SreeniEadara/ElectriPi/(commit log)

2022-04-28 more file repair
    [PiPowerHAT.kicad_pcb, PiPowerHAT.kicad_sch]
2022-04-30 Updating to add freewheeling diodes, power LEDs, etc.
    [PiPowerHAT.kicad_sch]
2022-05-01 adding footprints assignment to sch
    [PiPowerHAT.kicad_sch]
2022-05-01 currently under development. Layout in progress
    [PiPowerHAT.kicad_pcb, PiPowerHAT.kicad_sch]
2022-05-02 changed out fuseholder, mounting holes, headers, removed i2c, etc
    [PiPowerHAT.kicad_pcb, PiPowerHAT.kicad_sch]
2022-05-02 cleanup and added proper JLC number for fuseholder
    [PiPowerHAT.kicad_sch]
2022-05-03 Layout V1 complete
    [PiPowerHAT.kicad_pcb, PiPowerHAT.kicad_sch]
2022-05-04 Adding panelization between breakouts. Updated layout and component position.
    [PiPowerHAT.kicad_pcb, PiPowerHAT.kicad_sch, breakout.kicad_sch]
2022-05-05 remove breakout board and add +5V out
    [PiPowerHAT.kicad_pcb, PiPowerHAT.kicad_sch, breakout.kicad_sch]
2022-05-06 Cleanup and miscellaneous changes. Changed fuseholder and FET
    [PiPowerHAT.kicad_pcb, PiPowerHAT.kicad_sch]
2022-05-06 Minor Updates and Cleaning
    Changed JLC field to LCSC
    Changed Aux power output to JST XH
    Small changes to silkscreen labels to hide below components once fitted
    Added connector name labels to Frontsilk
    [PiPowerHAT.kicad_pcb, PiPowerHAT.kicad_sch]
2022-05-06 added additional silkscreen
    [PiPowerHAT.kicad_pcb]
2022-05-06 BOM Updates
    Mounting holes and other items not sent to automated manufacture excluded from BOM
    [PiPowerHAT.kicad_pcb, PiPowerHAT.kicad_sch]
2022-05-06 BOM and Gerber Generated
    BOM and Gerber Generated. Files sent for manufacture V0.1
    [PiPowerHAT-B_Cu.gbr, PiPowerHAT-B_Paste.gbr, PiPowerHAT-B_Silkscreen.gbr, PiPowerHAT-Edge_Cuts.gbr, PiPowerHAT-F_Cu.gbr, PiPowerHAT-F_Mask.gbr, PiPowerHAT-F_Paste.gbr, PiPowerHAT-F_Silkscreen.gbr]
2022-05-11 PCBway export and minor changes
    V0.1.1 files generated for PCBway with B.Mask included.
    Dot added to Pin 1 on F.silk
    Added Metadata to work with PCBway BOM
    [PiPowerHAT-B_Cu.gbr, PiPowerHAT-B_Mask.gbr, PiPowerHAT-B_Paste.gbr, PiPowerHAT-B_Silkscreen.gbr, PiPowerHAT-Edge_Cuts.gbr, PiPowerHAT-F_Cu.gbr, PiPowerHAT-F_Mask.gbr, PiPowerHAT-F_Paste.gbr]
2022-05-12 Part Numbers for Littelfuse removed.
    [PiPowerHAT.kicad_sch]
2022-05-18 bug fixes
    [PiPowerHAT.kicad_pcb, PiPowerHAT.kicad_sch]
2022-05-22 changing project name to remove 'HAT' designation
    [PowerPi-JLC.csv, PowerPi-PCBway.csv, PowerPi.csv, PowerPi.kicad_pcb, PowerPi.kicad_sch]
2022-05-25 changed input capacitors to 0402 footprint and updated layout to reduce EMI
    [PowerPi.kicad_pcb, PowerPi.kicad_sch]
2022-05-26 improved copper balance
    [PowerPi.kicad_pcb, PowerPi.kicad_sch]
2022-07-06 update to 1000 uF output electrolytic capacitor
    [PowerPi.kicad_pcb, PowerPi.kicad_sch]
2022-07-11 Production Changes
    Added LDO Naming to R.silk
    Fan JST XH pin +5 and GND swapped to match standard fans
    5V pwr LED resistor was 200R now 1KR
    24v pwr LED was 1.5k now 10k
    Changed sch symbol for XH to not have screws
    Added boxes to schematic layout
    Added title box entries to schematic
    [PowerPi-B_Cu.gbr, PowerPi-B_Mask.gbr, PowerPi-B_Paste.gbr, PowerPi-B_Silkscreen.gbr, PowerPi-Edge_Cuts.gbr, PowerPi-F_Cu.gbr, PowerPi-F_Mask.gbr, PowerPi-F_Paste.gbr]
2022-07-12 V1.0 Release
    Silkscreen adjustments
    [PiPowerHAT-B_Cu.gbr, PiPowerHAT-B_Mask.gbr, PiPowerHAT-B_Paste.gbr, PiPowerHAT-B_Silkscreen.gbr, PiPowerHAT-Edge_Cuts.gbr, PiPowerHAT-F_Cu.gbr, PiPowerHAT-F_Mask.gbr, PiPowerHAT-F_Paste.gbr]
2022-07-12 changing project name
    [ElectriPi-JLC.csv, ElectriPi-PCBway.csv, ElectriPi.csv, ElectriPi.kicad_pcb, ElectriPi.kicad_sch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]
2022-08-02 Bladefuse holder switched to Littelfuse nano 2 fuse holder
    [ElectriPi.kicad_pcb, ElectriPi.kicad_sch]
2022-12-05 F.Silk, Fan passthough, Fuse, XH input and designator changes
    - Added more pin notes to 40Pin GPIO
    - Added cutout to fan hole to allow passthrough from reverse mounting
    - customised F1 Littelfuse footprint to correctly suit NANO 2 footprint
    - Add JST XH Input Option
    - Moved superfluous reference designators to hidden layer (user2)
    [ElectriPi.kicad_pcb, ElectriPi.kicad_sch]
2022-12-07 Adding ICL footprint and schematic symbol
    [ElectriPi.kicad_pcb, ElectriPi.kicad_sch]
2022-12-07 adding test points
    [ElectriPi.kicad_pcb, ElectriPi.kicad_sch]
2022-12-14 Some small adjustment to silkscreen
    rotated TP on b.silk to match other text
    hid reference text for pin socket
    hid reference text for ICL
    [ElectriPi.kicad_pcb]
2022-12-14 small BOM updates
    [ElectriPi.kicad_sch]
2022-12-15 Adding Mouser part number for ICL
    [ElectriPi.kicad_sch]
2022-12-19 adding GND test point
    [ElectriPi.kicad_pcb, ElectriPi.kicad_sch]
2022-12-19 Back Silkscreen Adjustments
    Test point reference labels now hidden.
    Adjusted credentials to match ElectriPi Mini
    [ElectriPi.kicad_pcb, ElectriPi.kicad_sch]
2022-12-20 Changed thermal reliefs for ICL connection to pours
    [ElectriPi.kicad_pcb]
2022-12-20 Final Tweaks ready for production
    [ElectriPi-JLC.csv, ElectriPi-PCBway.csv, ElectriPi.kicad_pcb, ElectriPi.kicad_sch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]
2023-01-17 Remove outdated .csv
    [ElectriPi.csv]
